Source-Robotics/MSG-compliant-AI-stepper-gripper/Photos/camera_OV9732.jpg

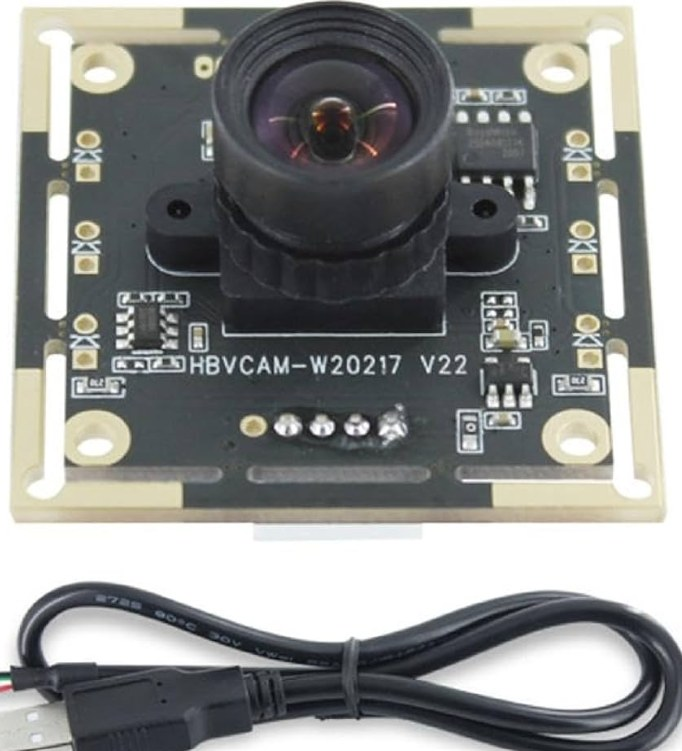
Photos/camera_OV9732.jpg
