Source-Robotics/MSG-compliant-AI-stepper-gripper/Photos/gear_32P_21T.jpg

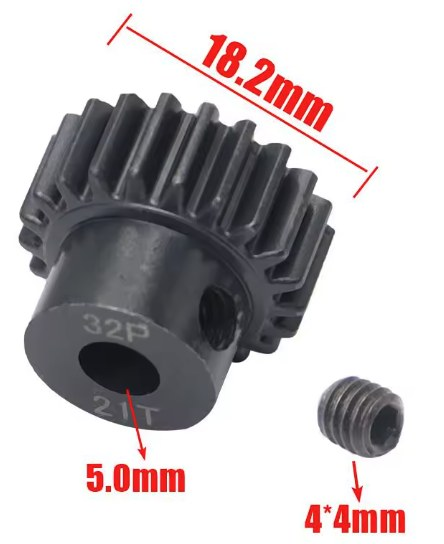
Photos/gear_32P_21T.jpg
