Source-Robotics/MSG-compliant-AI-stepper-gripper/Photos/PETG.jpg

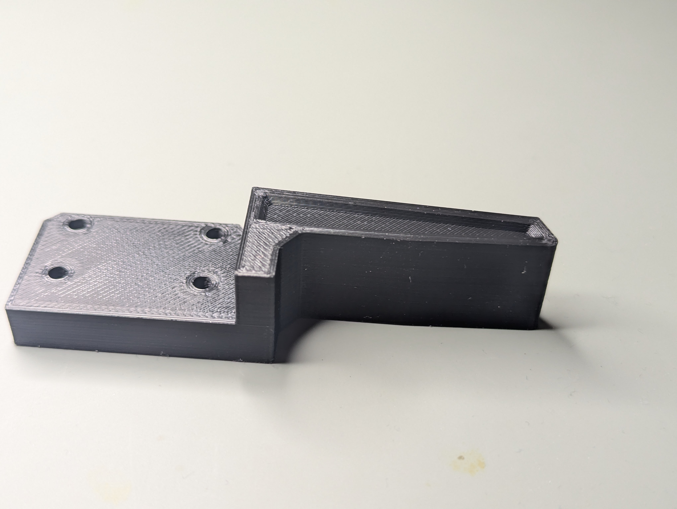
Photos/PETG.jpg
