Source-Robotics/MSG-compliant-AI-stepper-gripper/Photos/STEPFOC.png

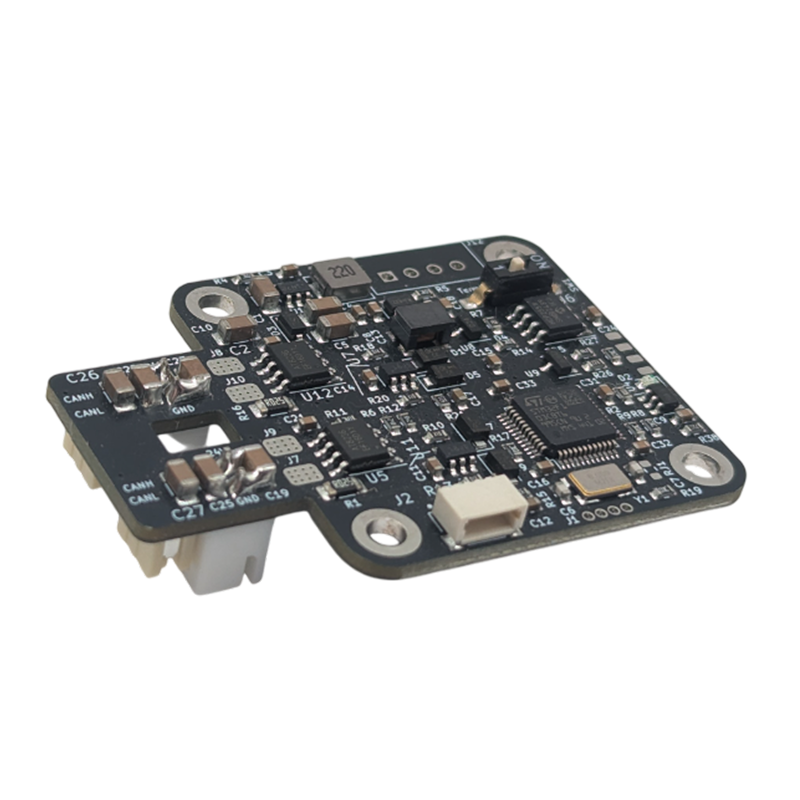
Photos/STEPFOC.png
