Source-Robotics/MSG-compliant-AI-stepper-gripper/Photos/stepper_21_5mm.jpg

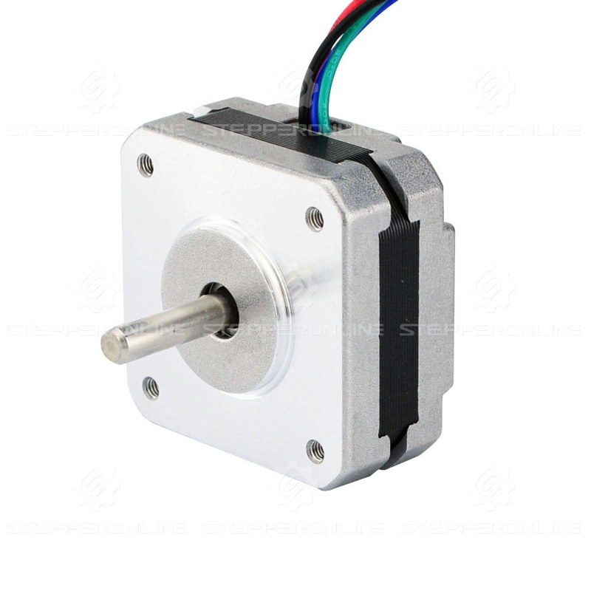
Photos/stepper_21_5mm.jpg
