Source-Robotics/MSG-compliant-AI-stepper-gripper/Photos/stepper_40mm.jpg

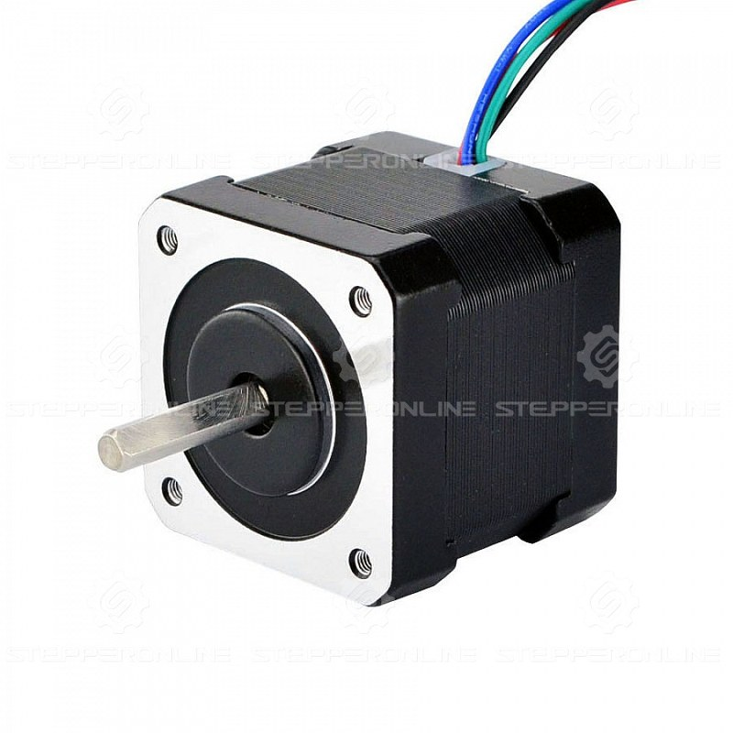
Photos/stepper_40mm.jpg
