Source-Robotics/MSG-compliant-AI-stepper-gripper/Photos/stepper_60mm.jpg

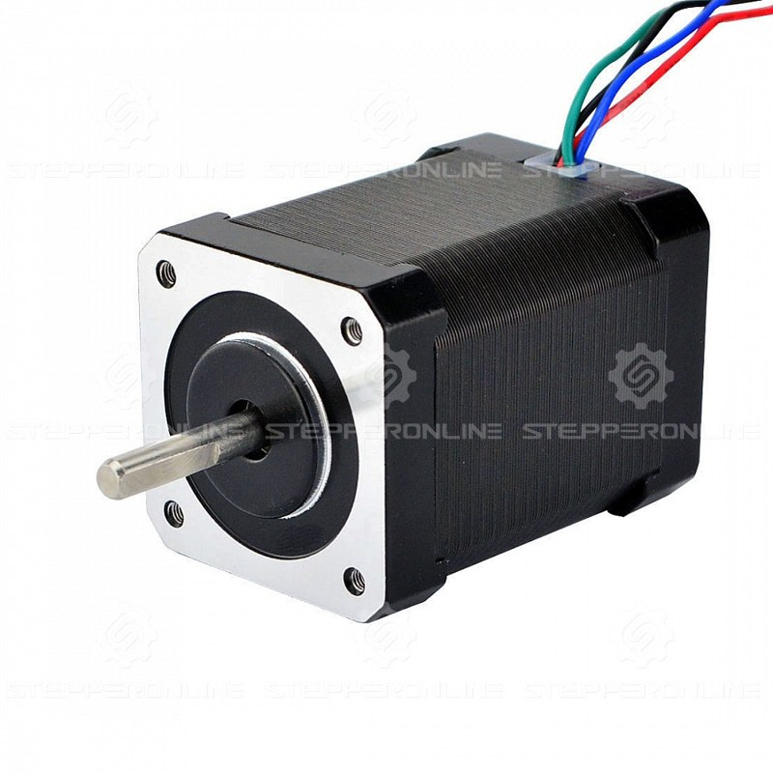
Photos/stepper_60mm.jpg
