Source-Robotics/MSG-compliant-AI-stepper-gripper/STEP files/Gripper jaws attachment/MSG_JAW_HOLLOW.STEP

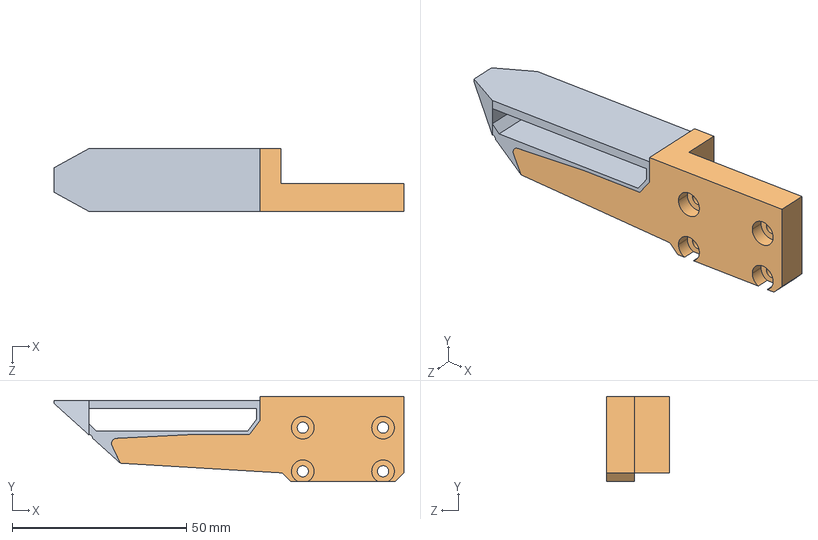
[picture p12: CAD file, 2026-07-07]
STEP files/Gripper jaws attachment/MSG_JAW_HOLLOW.STEP
100.3 x 24.4 x 18.0 mm
