Source-Robotics/MSG-compliant-AI-stepper-gripper/STEP files/Linear rail dependant parts/100mm rail/MSG_Gripper_body_100mm.STEP

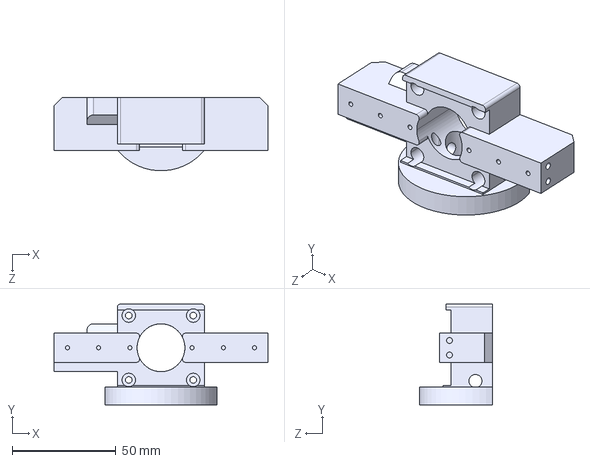
[picture p13: CAD file, 2026-08-24]
STEP files/Linear rail dependant parts/100mm rail/MSG_Gripper_body_100mm.STEP
103.0 x 48.5 x 35.3 mm
