Source-Robotics/MSG-compliant-AI-stepper-gripper/STEP files/Linear rail dependant parts/150mm rail/MSG_Gripper_body_150mm.STEP

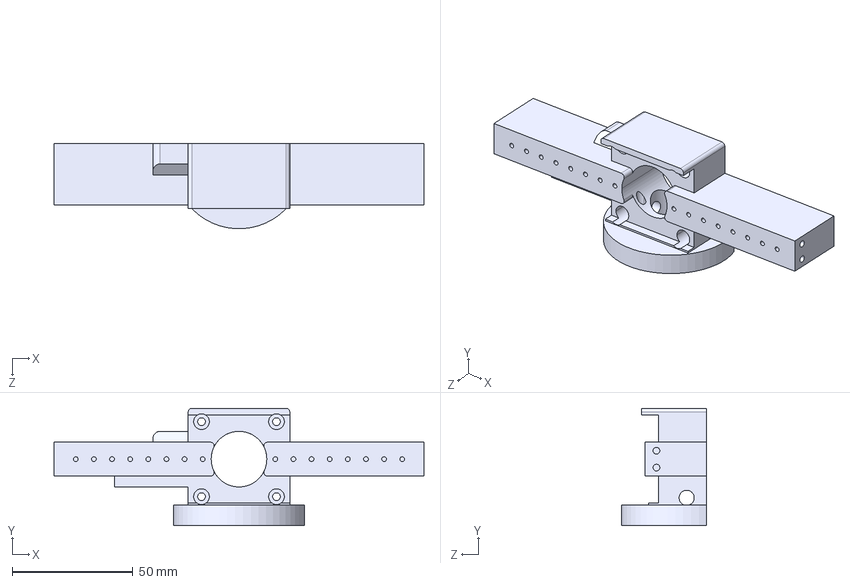
[picture p14: CAD file, 2026-08-24]
STEP files/Linear rail dependant parts/150mm rail/MSG_Gripper_body_150mm.STEP
153.0 x 48.5 x 35.3 mm
