Source-Robotics/MSG-compliant-AI-stepper-gripper/STEP files/Linear rail dependant parts/200mm rail/MSG_Gripper_body_200mm.STEP

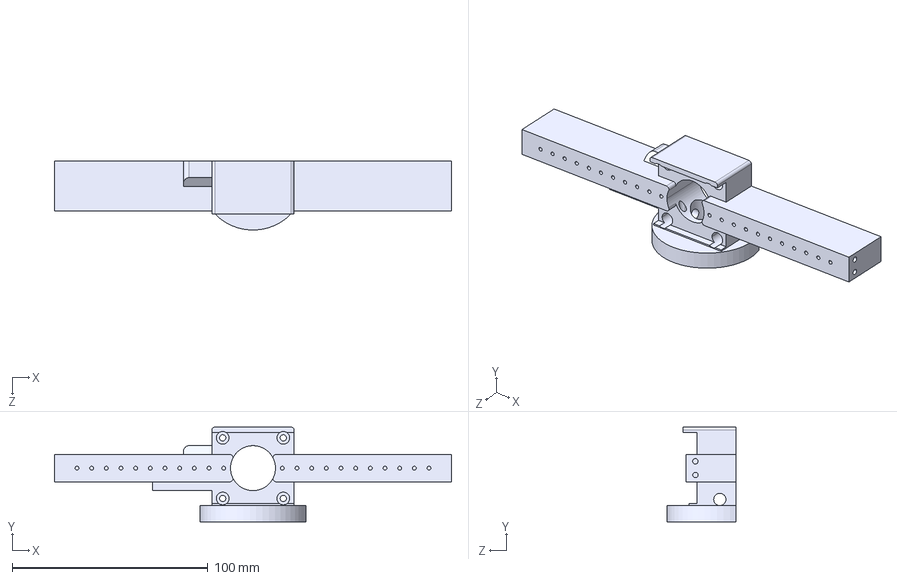
[picture p15: CAD file, 2026-08-24]
STEP files/Linear rail dependant parts/200mm rail/MSG_Gripper_body_200mm.STEP
203.0 x 48.5 x 35.3 mm
