Source-Robotics/MSG-compliant-AI-stepper-gripper/STEP files/Stepper dependant parts/21_5mm stepper/Stepper_spacer_21_5.STEP

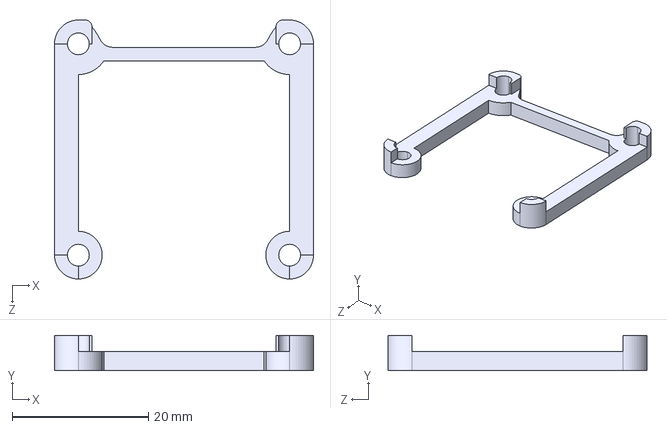
[picture p16: CAD file, 2026-07-09]
STEP files/Stepper dependant parts/21_5mm stepper/Stepper_spacer_21_5.STEP
38.0 x 5.15 x 38.0 mm
