Source-Robotics/MSG-compliant-AI-stepper-gripper/(list of files, cad)

Other CAD files:
STEP files/Gripper jaws attachment/MSG_JAW_HOLLOW.3MF
