Source-Robotics/MSG-compliant-AI-stepper-gripper/(commit log)

2026-06-27 Update BOM
2026-07-07 Gripper jaws guide
2026-10-31 BOM: reference images for the parts that had none, from the PAROL6, PAR6 and RCB BOMs; the encoder magnet's shop link
2026-10-31 BOM: photos of the MGN7C slider and rail, the diametric magnet, the gear and the camera
2026-10-31 BOM: separate photos of the MGN7C carriage and the MGN7 rail
2026-11-01 Add MSG guide links for MSG built-in camera previews
2026-11-03 Pin guide links to the final validated MoveIt source
2026-11-04 CITATION.cff: GitHub's Cite this repository button (Source Robotics, Petar Crnjak)
